asantos2000/TelosB/pictures/Screen Shot 2016-05-10 at 8.43.21 AM.png

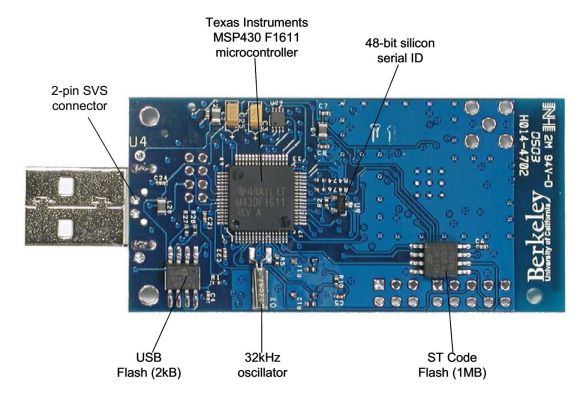
pictures/Screen Shot 2016-05-10 at 8.43.21 AM.png
