asantos2000/TelosB/pictures/Screen Shot 2016-05-10 at 8.43.06 AM.png

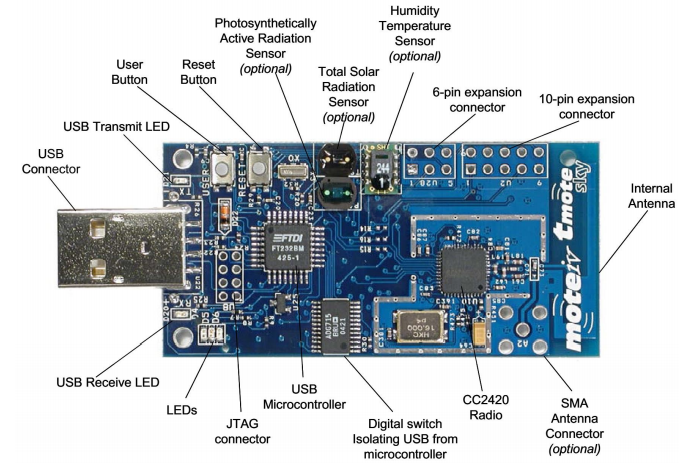
pictures/Screen Shot 2016-05-10 at 8.43.06 AM.png
