asantos2000/TelosB/UCB/README.txt

PCB DECRIPTION: 1.267 inches x 2.582 inches
                4 LAYER PCB 1.0 MM (0.040 inch) FR4
                LAYER SPACING:
                1-2 0.25 MM
                2-3 0.4 MM
                3-4 0.25 MM
                1 oz copper pour, solder plated finish
                DOUBLE SIDE SOLDER MASK,
                DOUBLE SIDE SILKSCREEN,
                8 MIL MIN TRACE WIDTH AND 8 MIL MIN ISOLATION BOT,IN1,GND
                6 MIL MIN TRACE WIDTH AND 6 MIL MIN ISOLATION TOP
                10 MIL MIN HOLE SIZE

Note: Please use green silk screen

The left side of the board has an inverted-F antenna with 
no surface mount pads. PLEASE DO NOT PUT ANY COPPER MARKINGS
IN THAT AREA.

Questions?
  Please contact Joe Polastre <polastre@cs.berkeley.edu>
  at 510.388.2112 with any problems or questions

TOP.GBX - Top Copper
GND.GBX - Inner Plane Negative Polarity
IN1.GBX - Inner Plane Positive Polarity
BOT.GBX - Bottom Copper

drill.nc - NC Drill File

SMT.GBX - Surface Mount Top
SMB.GBX - Surface Mount Bottom

SST.GBX - Silk Screen Top
SSB.GBX - Slik Screen Bottom

telos-ti-63fab.dxf - fabrication drawing

Note: TELOS-TI-63b.GTD is a GerbTool V10 file that contains the above layers
