asantos2000/TelosB/pictures/BOT.GBX.png

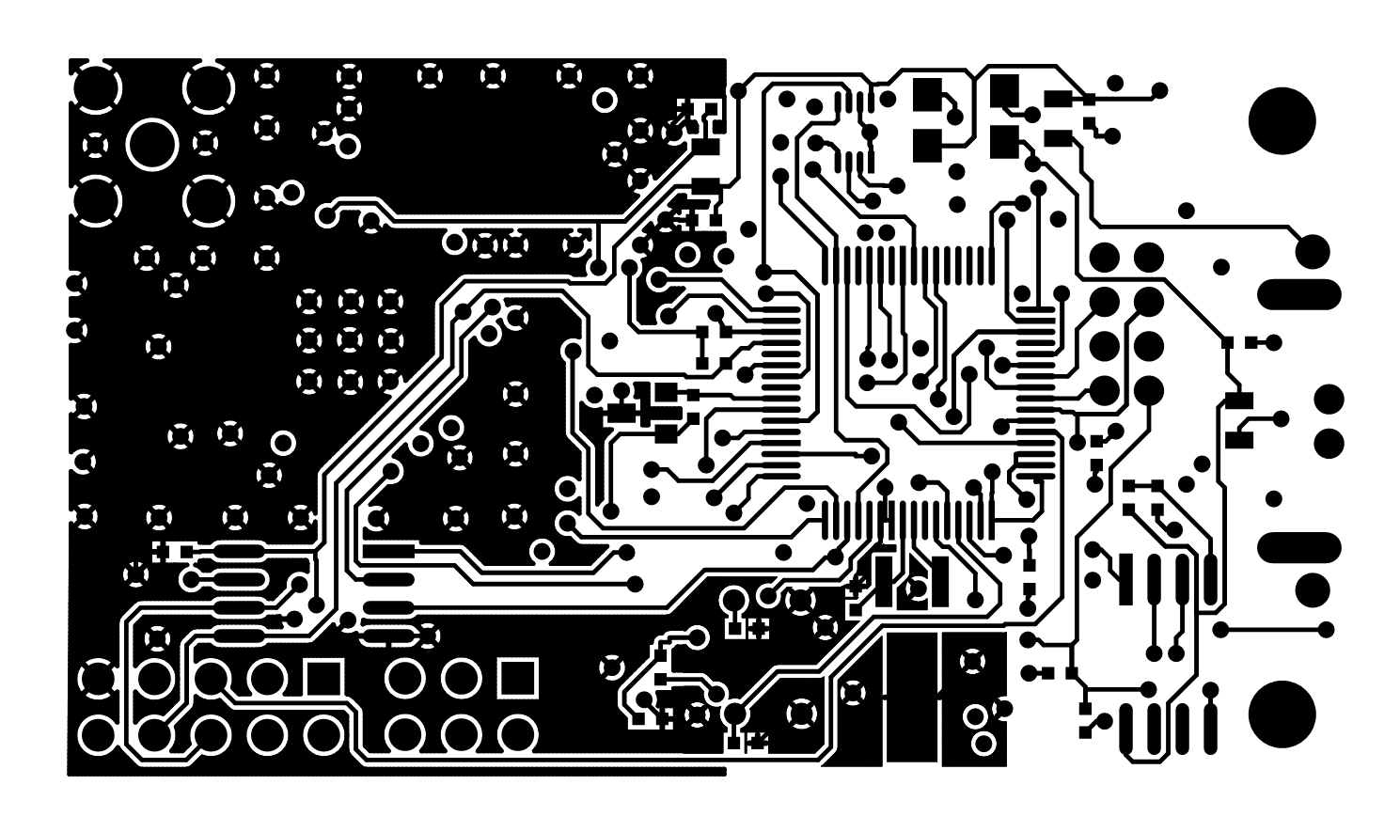
pictures/BOT.GBX.png
