asantos2000/TelosB/pictures/GND.GBX.png

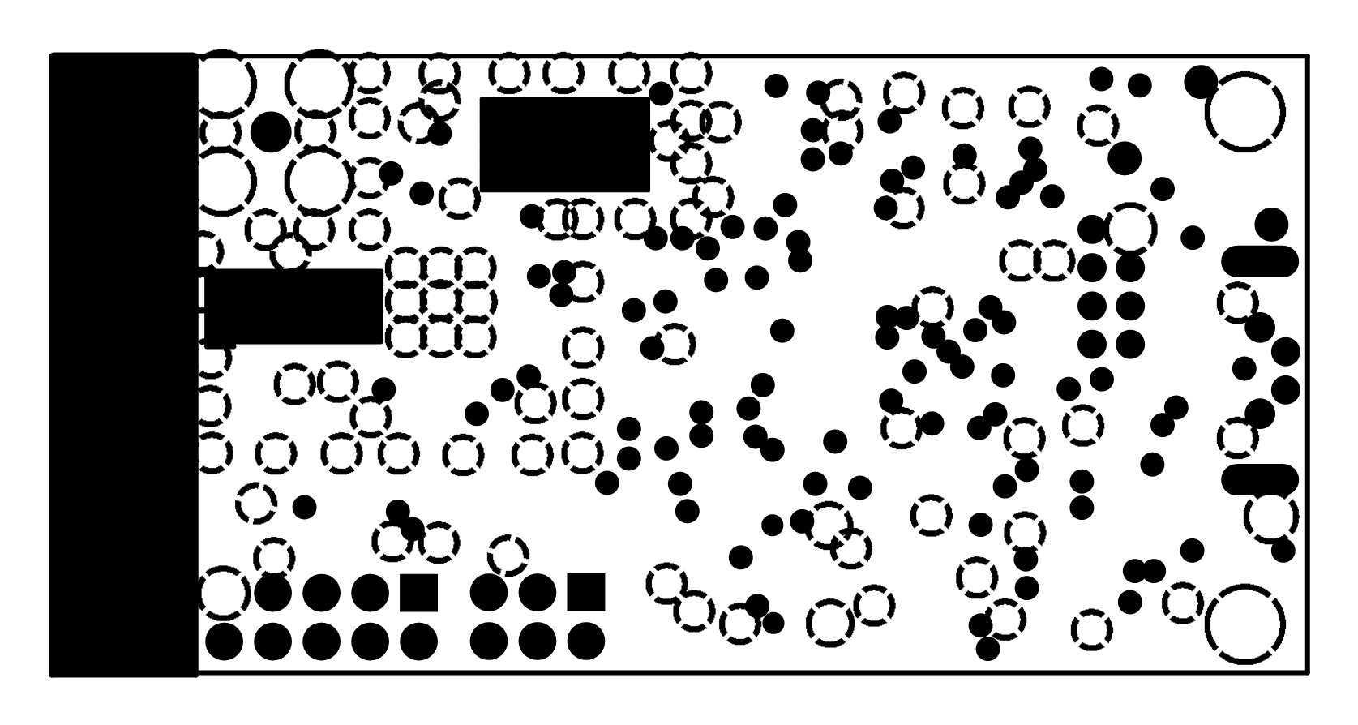
pictures/GND.GBX.png
