asantos2000/TelosB/pictures/IN1.GBX.png

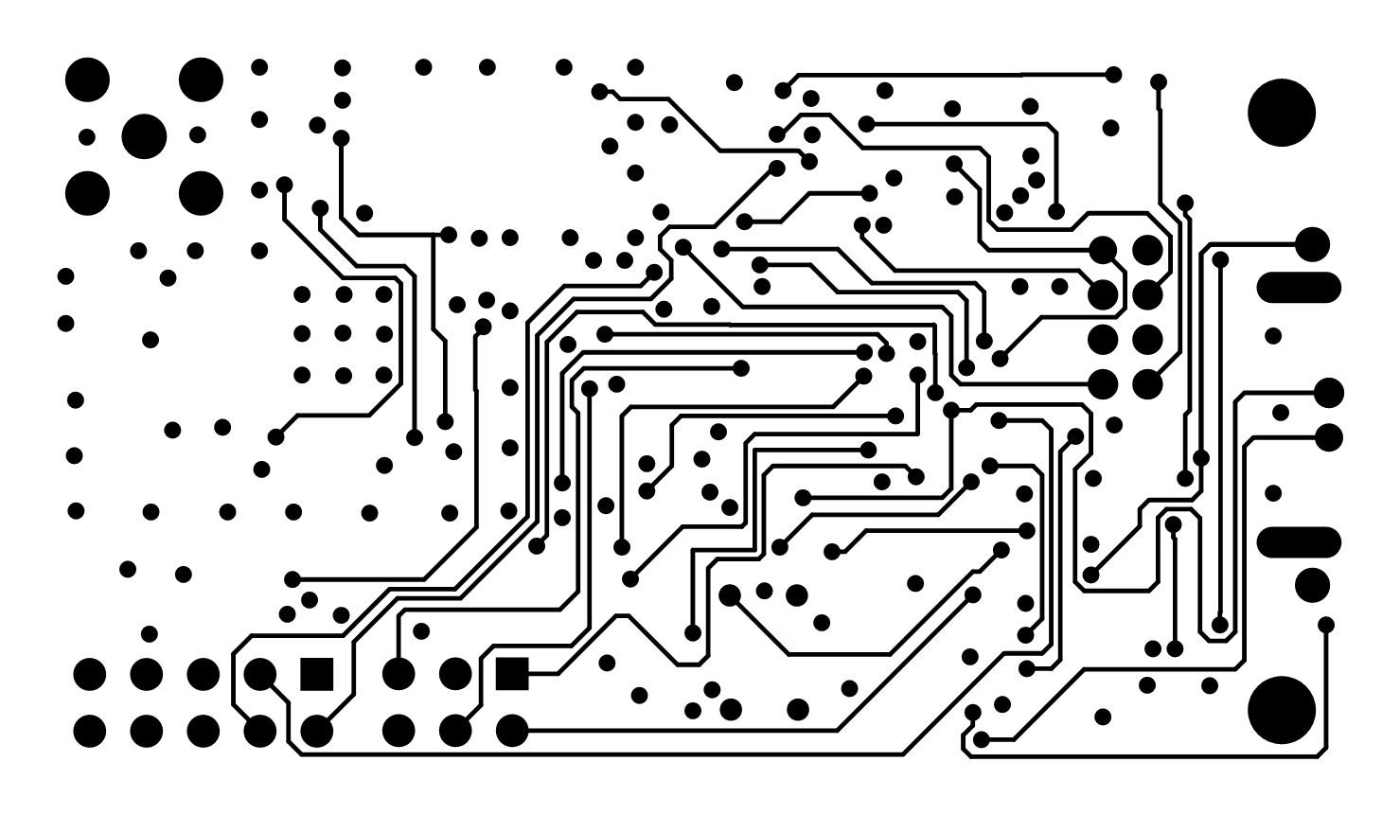
pictures/IN1.GBX.png
