asantos2000/TelosB/pictures/SMB.GBX.png

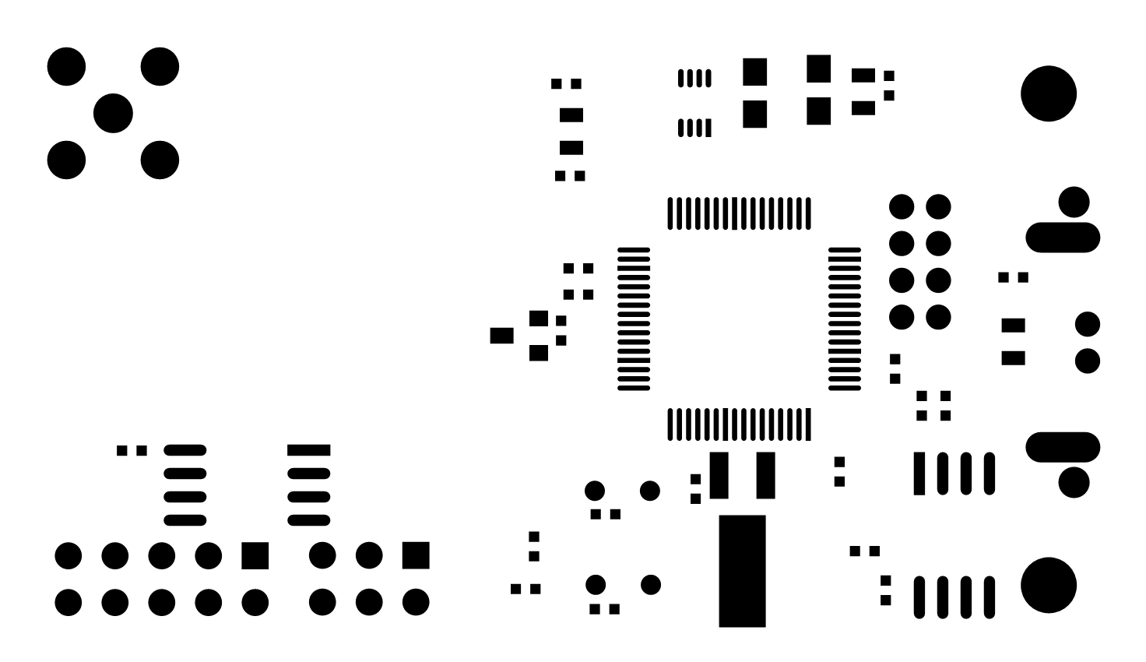
pictures/SMB.GBX.png
