asantos2000/TelosB/pictures/SSB.GBX.png

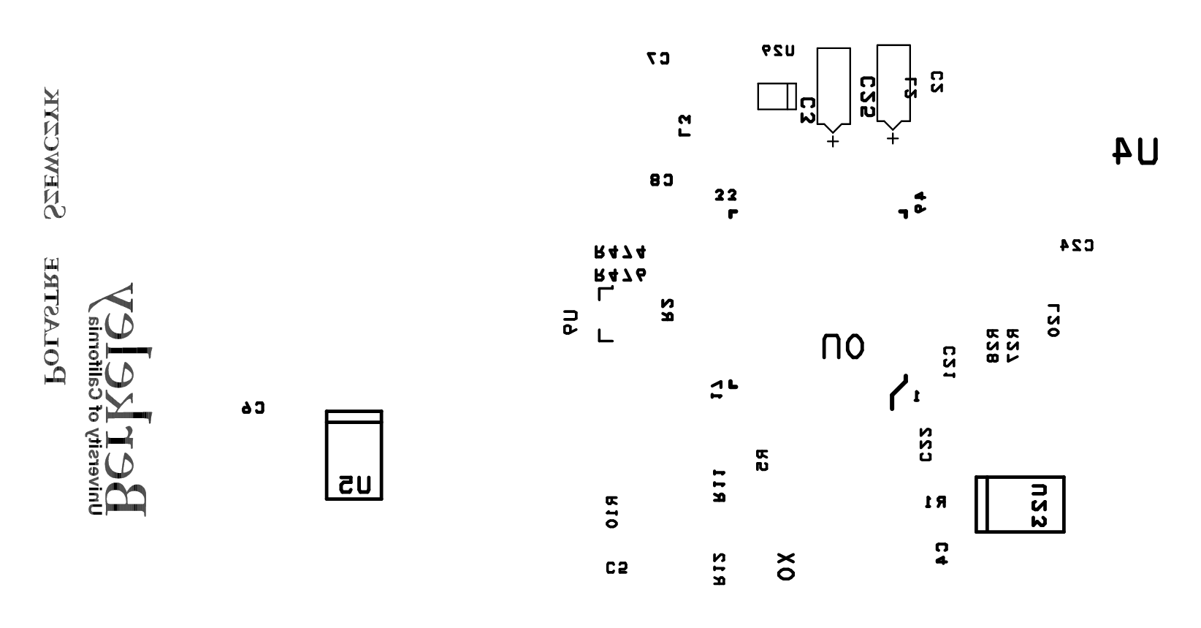
pictures/SSB.GBX.png
