asantos2000/TelosB/pictures/SST.GBX.png

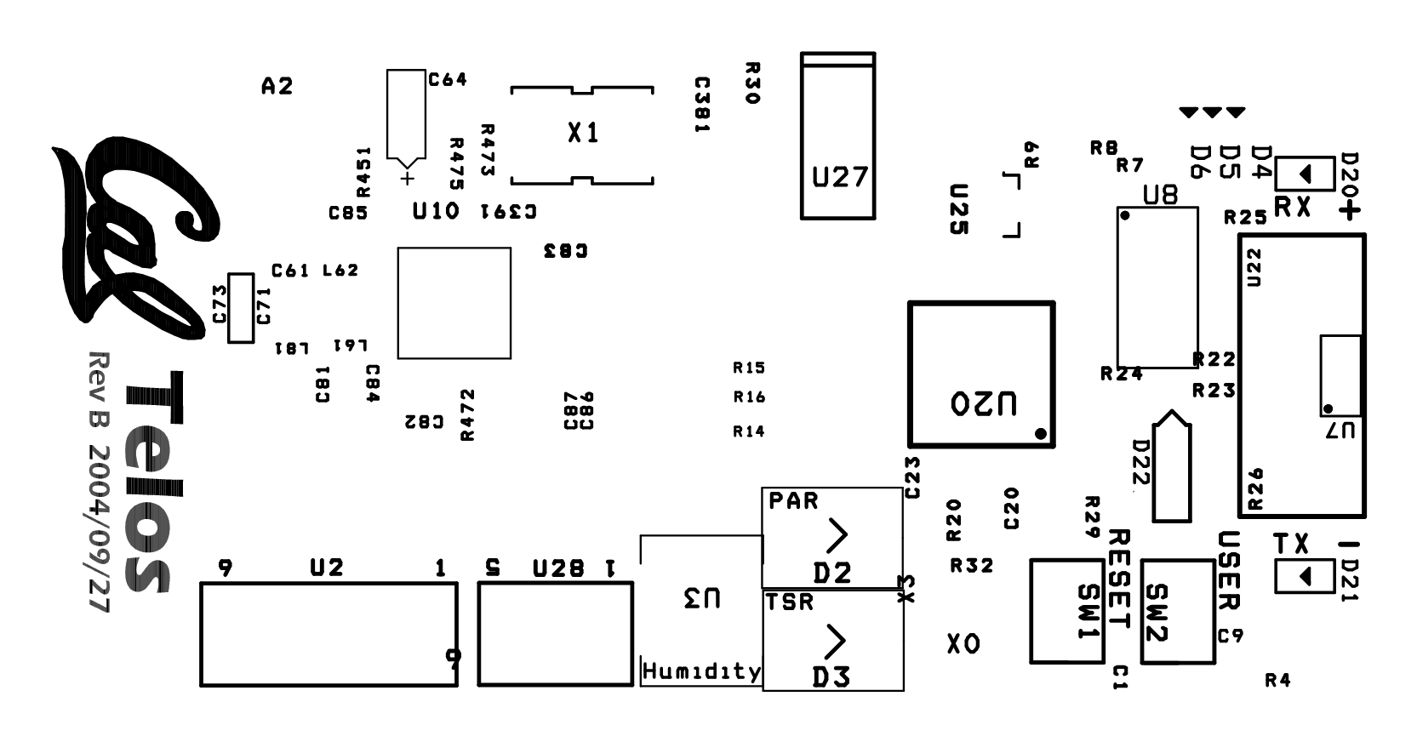
pictures/SST.GBX.png
