asantos2000/TelosB/pictures/telos-ti-63fab.png

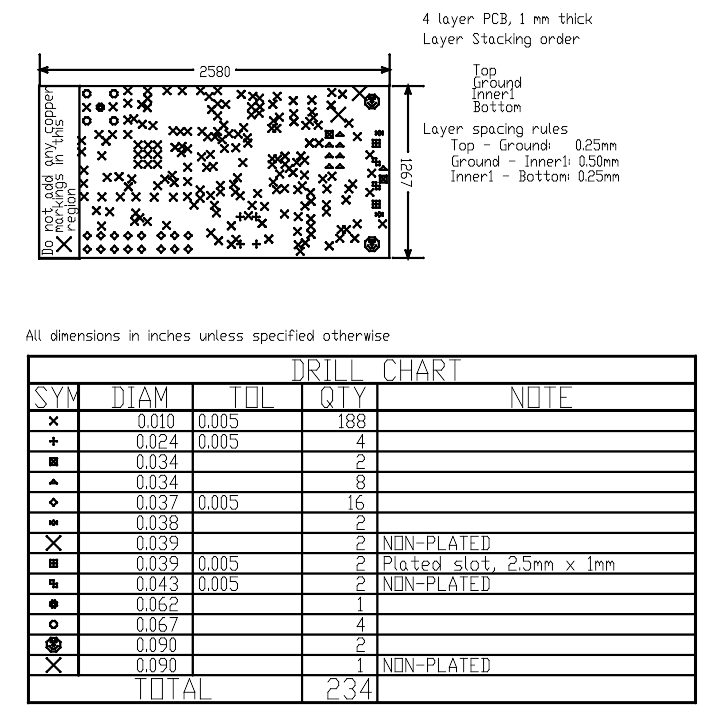
pictures/telos-ti-63fab.png
