asantos2000/TelosB/pictures/TOP.GBX.png

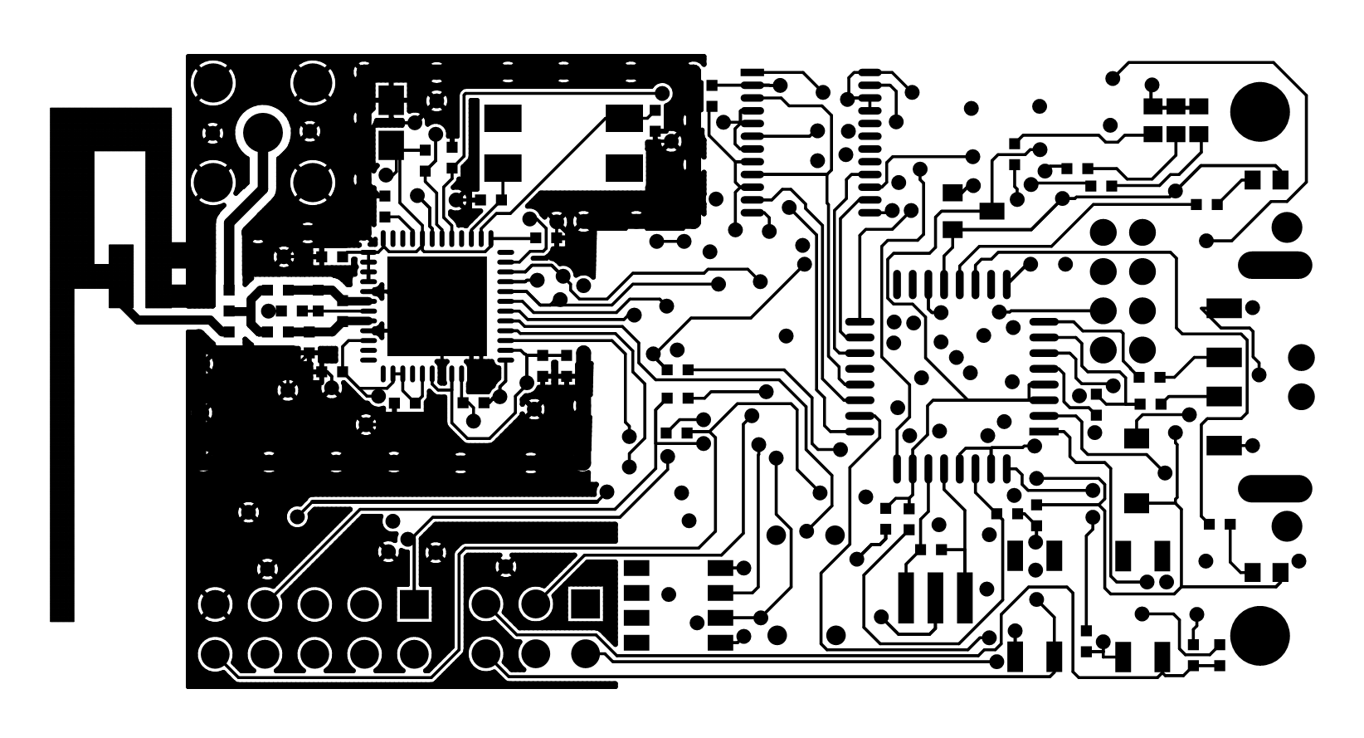
pictures/TOP.GBX.png
