asantos2000/TelosB/telos-revb-bom-2016-05-24.xlsx

Sheet: proposta
maggie@winwin-custom.com |  |  | angel@morepcb.com |  |  | sales@umebay.net
Qde | 10 | 50 | Qde | 10 | 50 | Qde | 10 | 50
MOQ (PCB) | 6.00 | 1.60 | MOQ (PCB) |  |  | MOQ (PCB) | 3.60 | 1.06
COMP (elect. parts) | 42.28 | 42.28 | COMP (elect. parts) |  |  | COMP (elect. parts) | 50.00 | 41.40
Assembly (SMT) | 14.40 | 8.00 | Assembly (SMT) |  |  | Assembly (SMT) | 10.00 | 3.00
Stencil | 30.00 | 30.00 | Stencil |  |  | Stencil
Total | 656.78 | 2623.90 | Total | 300.00 | 1250.00 | Total | 636.00 | 2273.00
Unit USD | 65.678 | 52.478 | Unit USD | 30 | 25 | Unit USD | 63.6 | 45.46

Sheet: UMEBAY
UMEBAY ELECTRONICS COMPANY LIMITED http://www.umebay.net
Shenzhen Add: B2303, 3 Lipu road Bantian , Longgang District, Shenzhen, P.R.C
Tel:0755-83209137 skype:xiangtao.ouyang
Email address: sales@umebay.net
Quotation sheet
In#NO.TR2016051101
Date 11.May.2016
FOR:Anderson (adsantos@gmail.com)
Project name | size | quantity | PCB fee | SMT fee | Cost of electronic part | other | total (USD)
telos-revb-r63 | 1.267*2.582 | 10pcs | $36.00 | $100.00 | $500.00 |  | $636.00
telos-revb-r63 | 1.267*2.582 | 50pcs | $53.00 | $150.00 | $2070.00 |  | $2273.00
not: Production time (7-15days) All parts are high quality.
Accept:PAYPAL ,Aliexpress ,T/T payment
Free shipping to your designated location
 |  |  |  |  |  | date: | 2016 May 11th

Sheet: winwin_telos-bom-2016-05-24
Telos (Rev B) Revised: Saturday, September 21, 2004
(c) Copyright 2004: UC Berkeley Revision: B
Bill Of Materials May 24,2016 10:00:00
Item | Quantity | Reference | Part | Footprint | price | total
______________________________________________
1 | 1 | A1 | CC2420_PCB_ANT | ANTENNA/CC2420
2 | 1 | C84 | 10n | SM/C_0402 | 0.007 | 0.007
3 | 1 | C21 | 33n | SM/C_0402 | 0.007 | 0.007
4 | 2 | C81,C61 | 0.5p +/-0.25p np0 | SM/C_0402 | 0.011 | 0.022
5 | 2 | C71,C73 | 5.6p +/-0.25p np0 | SM/C_0402/DUAL/INLINE | 0.011 | 0.022
6 | 2 | C381,C391 | 22p 5% np0 | SM/C_0402 | 0.007 | 0.014
7 | 3 | C82,C83,C86 | 68p | SM/C_0402 | 0.007 | 0.021
8 | 14 | C1,C2,C4,C5,C6,C7,C8,C9,C20,C22,C23,C24,C85,C87 | 0.1u | SM/C_0402 | 0.007 | 0.098
9 | 3 | C3,C25,C64 | 10uF LowESR < 5ohm | SM/TANT_A_NUM | 0.540 | 1.620 | TPSC106K025R0500
10 | 2 | D4,D21 | Red Clear - QTLP601C-7 | LED SMD 0603 NUM | 0.017 | 0.034
11 | 2 | D5,D20 | Green Clear - QTLP601C-4 | LED SMD 0603 NUM | 0.017 | 0.034
12 | 1 | D6 | Blue Clear - QTLP601C-EB | LED SMD 0603 NUM | 0.022 | 0.022
13 | 1 | D22 | 1N5817 | SSS Mini 2P | 0.065 | 0.065
14 | 3 | J10,J11,J12 | HOLE | 90_mil_hole | 0.420 | 1.260
15 | 3 | L2,L3,L20 | F Bead 240-1035-1 | SM/C_0805 | 0.022 | 0.066
16 | 1 | L62 | 5.6n 5% | SM/C_0402 | 0.017 | 0.017
17 | 2 | L81,L61 | 7.5n 5% | SM/C_0402 | 0.017 | 0.034
18 | 1 | R475 | 0 | SM/C_0402 | 0.004 | 0.004
19 | 2 | R22,R23 | 27 | SM/C_0402 | 0.004 | 0.008
20 | 3 | R9,R25,R26 | 100 | SM/C_0402 | 0.004 | 0.012
21 | 1 | R8 | 220 | SM/C_0402 | 0.004 | 0.004
22 | 2 | R7,R20 | 470 | SM/C_0402 | 0.004 | 0.008
23 | 1 | R24 | 1.5k | SM/C_0402 | 0.004 | 0.004
24 | 2 | R2,R27 | 2.2k | SM/C_0402 | 0.004 | 0.008
25 | 6 | R10,R28,R29,R30,R474,R476 | 10k | SM/C_0402 | 0.004 | 0.024
26 | 1 | R451 | 43k 1% | SM/C_0402 | 0.004 | 0.004
27 | 3 | R1,R11,R12 | 100k 1% | SM/C_0402 | 0.004 | 0.012
28 | 1 | R4 | 470k | SM/C_0402 | 0.004 | 0.004
29 | 3 | R32,R472,R473 | 1m | SM/C_0402 | 0.004 | 0.012
30 | 1 | R5 | 5.1m | SM/C_0402 | 0.004 | 0.004
31 | 2 | SW2,SW1 | EVQ-P2K02Q | SW/EVQP2 | 0.542 | 1.084
32 | 1 | U0 | TI_MSP430_F1611 | QUAD.50M/64/WG12.00 | 5.940 | 5.940 | MSP430F1611IPM
33 | 1 | U4 | PWR_CONN | AA AA Battery Storage Case Plastic Box Holder with 6'' Cable Lead for 2 x AA 1.5V | 0.300 | 0.300
34 | 1 | U5 | M25P80 | SOIC 8PIN 150MIL | 0.433 | 0.433 | M25P80-VMW6TG
35 | 1 | U9 | DS2411 | SOT321 | 0.368 | 0.368
36 | 1 | U10 | CC2420 | QLP/48 | 3.510 | 3.510 | CC2420RGZR
37 | 1 | U20 | FT232BM | LQFP/32-LD | 3.420 | 3.420 | FT232BL (new)
38 | 1 | U22 | USB A | USB-A-SPM-K-O-L | 0.065 | 0.065
39 | 1 | U23 | M93C56-WMN6P | SOIC 8PIN 150MIL | 0.400 | 0.400
40 | 1 | U25 | MCP1700T-3302TT | SOT231 | 0.433 | 0.433
41 | 1 | U27 | ADG715BRU | TSSOP/24 | 4.225 | 4.225
42 | 1 | U29 | NC7WZ126 | US/8 | 0.184 | 0.184 | NC7WZ126K8X
43 | 1 | X0 | 32kHz | CMR200TB | 0.130 | 0.130
44 | 1 | X1 | 16MHZ - 16pf | HK-XTAL-7X5 | 0.238 | 0.238
45 | 1 | X3 | 6M resonator | MURATA_CSTCR CSTCR6M00G53-RO CSTCR 6 MHZ | 0.198 | 0.198
SENSORS
46 | 1 | D2 | S1087 Photodiode | HAM S1087 | 6.000 | 6.000
47 | 1 | D3 | S1087-01 Photodiode | HAM S1087 | 5.660 | 5.660
48 | 1 | U3 | SHT11 | SHT11_SMALL | 6.140 | 6.140 | IC
 |  |  |  |  |  | 0.000
DO NOT POPULATE |  |  |  |  |  | 0.000
49 | 1 | A2 | SMA | SMA_PCB |  | 0.000
50 | 3 | R14,R15,R16 | 0 open | SM/C_0402
51 | 1 | U2 | 10pin Header - 0.1" | BLKCON.100/VH/TM2OE/W.200/10 | 0.033 | 0.033
52 | 1 | U7 | 2pin Header - 2mm | BLKCON2MM/2/2 | 0.022 | 0.022
53 | 1 | U8 | 8pin Header - 2mm | BLKCON2MM/2/8 | 0.022 | 0.022
54 | 1 | U28 | 6pin Header - 0.1" | BLKCON.100/VH/TM2OE/W.200/6 | 0.022 | 0.022
 |  |  |  |  |  | 42.278
