asantos2000/TelosB/telos-revb-bom-2004-09-21.xls

Telos (Rev B) Revised: Saturday, September 21, 2004
(c) Copyright 2004: UC Berkeley Revision: B
Bill Of Materials September 21,2004 19:25:18
Item | Quantity | Reference | Part | Footprint
______________________________________________
1 | 1 | A1 | CC2420_PCB_ANT | ANTENNA/CC2420
2 | 1 | C84 | 10n | SM/C_0402
3 | 1 | C21 | 33n | SM/C_0402
4 | 2 | C81,C61 | 0.5p +/-0.25p np0 | SM/C_0402
5 | 2 | C71,C73 | 5.6p +/-0.25p np0 | SM/C_0402/DUAL/INLINE
6 | 2 | C381,C391 | 22p 5% np0 | SM/C_0402
7 | 3 | C82,C83,C86 | 68p | SM/C_0402
8 | 14 | C1,C2,C4,C5,C6,C7,C8,C9,C20,C22,C23,C24,C85,C87 | 0.1u | SM/C_0402
9 | 3 | C3,C25,C64 | 10uF LowESR < 5ohm | SM/TANT_A_NUM
10 | 2 | D4,D21 | Red Clear - QTLP601C-7 | LED SMD 0603 NUM
11 | 2 | D5,D20 | Green Clear - QTLP601C-4 | LED SMD 0603 NUM
12 | 1 | D6 | Blue Clear - QTLP601C-EB | LED SMD 0603 NUM
13 | 1 | D22 | 1N5817 | SSS Mini 2P
14 | 3 | J10,J11,J12 | HOLE | 90_mil_hole
15 | 3 | L2,L3,L20 | F Bead 240-1035-1 | SM/C_0805
16 | 1 | L62 | 5.6n 5% | SM/C_0402
17 | 2 | L81,L61 | 7.5n 5% | SM/C_0402
18 | 1 | R475 | 0 | SM/C_0402
19 | 2 | R22,R23 | 27 | SM/C_0402
20 | 3 | R9,R25,R26 | 100 | SM/C_0402
21 | 1 | R8 | 220 | SM/C_0402
22 | 2 | R7,R20 | 470 | SM/C_0402
23 | 1 | R24 | 1.5k | SM/C_0402
24 | 2 | R2,R27 | 2.2k | SM/C_0402
25 | 6 | R10,R28,R29,R30,R474,R476 | 10k | SM/C_0402
26 | 1 | R451 | 43k 1% | SM/C_0402
27 | 3 | R1,R11,R12 | 100k 1% | SM/C_0402
28 | 1 | R4 | 470k | SM/C_0402
29 | 3 | R32,R472,R473 | 1m | SM/C_0402
30 | 1 | R5 | 5.1m | SM/C_0402
31 | 2 | SW2,SW1 | EVQ-P2K02Q | SW/EVQP2
32 | 1 | U0 | TI_MSP430_F1611 | QUAD.50M/64/WG12.00
33 | 1 | U4 | PWR_CONN | AA
34 | 1 | U5 | M25P80 | SOIC 8PIN 150MIL
35 | 1 | U9 | DS2411 | SOT321
36 | 1 | U10 | CC2420 | QLP/48
37 | 1 | U20 | FT232BM | LQFP/32-LD
38 | 1 | U22 | USB A | USB-A-SPM-K-O-L
39 | 1 | U23 | 93C46 | SOIC 8PIN 150MIL
40 | 1 | U25 | MCP1700T-3302TT | SOT231
41 | 1 | U27 | ADG715BRU | TSSOP/24
42 | 1 | U29 | NC7WZ126 | US/8
43 | 1 | X0 | 32kHz | CMR200TB
44 | 1 | X1 | 16MHZ - 16pf | HK-XTAL-7X5
45 | 1 | X3 | 6M resonator | MURATA_CSTCR
SENSORS
46 | 1 | D2 | S1087 Photodiode | HAM S1087
47 | 1 | D3 | S1087-01 Photodiode | HAM S1087
48 | 1 | U3 | SHT11 | SHT11_SMALL
DO NOT POPULATE
49 | 1 | A2 | SMA | SMA_PCB
50 | 3 | R14,R15,R16 | 0 open | SM/C_0402
51 | 1 | U2 | 10pin Header - 0.1" | BLKCON.100/VH/TM2OE/W.200/10
52 | 1 | U7 | 2pin Header - 2mm | BLKCON2MM/2/2
53 | 1 | U8 | 8pin Header - 2mm | BLKCON2MM/2/8
54 | 1 | U28 | 6pin Header - 0.1" | BLKCON.100/VH/TM2OE/W.200/6
