asantos2000/TelosB/UCB/telos-ti-63fab.dxf

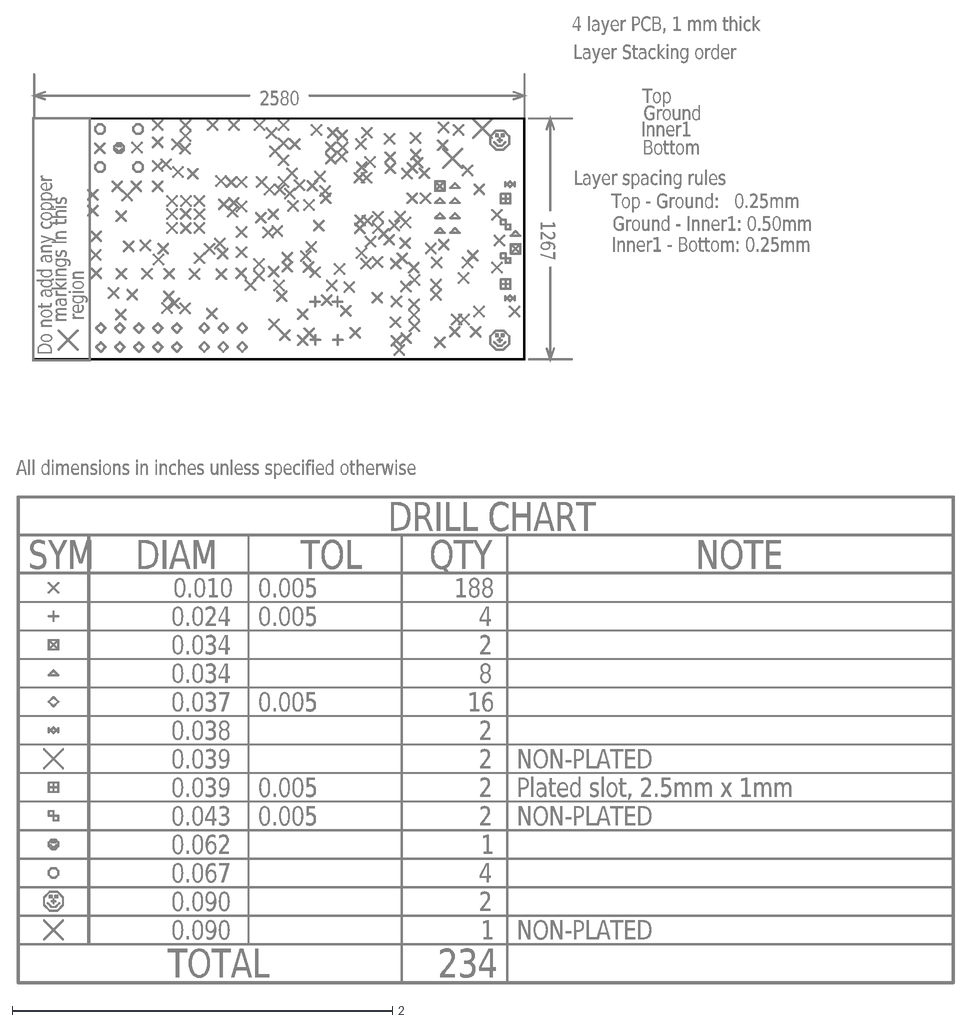
[picture p12: CAD file, 2016-05-24]
UCB/telos-ti-63fab.dxf
2580
1267
Layer Stacking order
Top
Ground
Inner1
Bottom
All dimensions in inches unless specified otherwise
Do not add any copper
markings in this
region
4 layer PCB, 1 mm thick
Layer spacing rules
Top - Ground: 0.25mm
Ground - Inner1: 0.50mm
Inner1 - Bottom: 0.25mm
DRILL CHART
SYM
DIAM
TOL
QTY
NOTE
0.010
0.005
188
0.024
4
0.034
2
8
0.037
16
0.038
0.039
NON-PLATED
Plated slot, 2.5mm x 1mm
0.043
0.062
1
0.067
0.090
TOTAL
234
