asantos2000/TelosB/pictures/telos-revb-2004-09-27_schematic.pdf

SENSORS | POWER

# RESET SWITCH

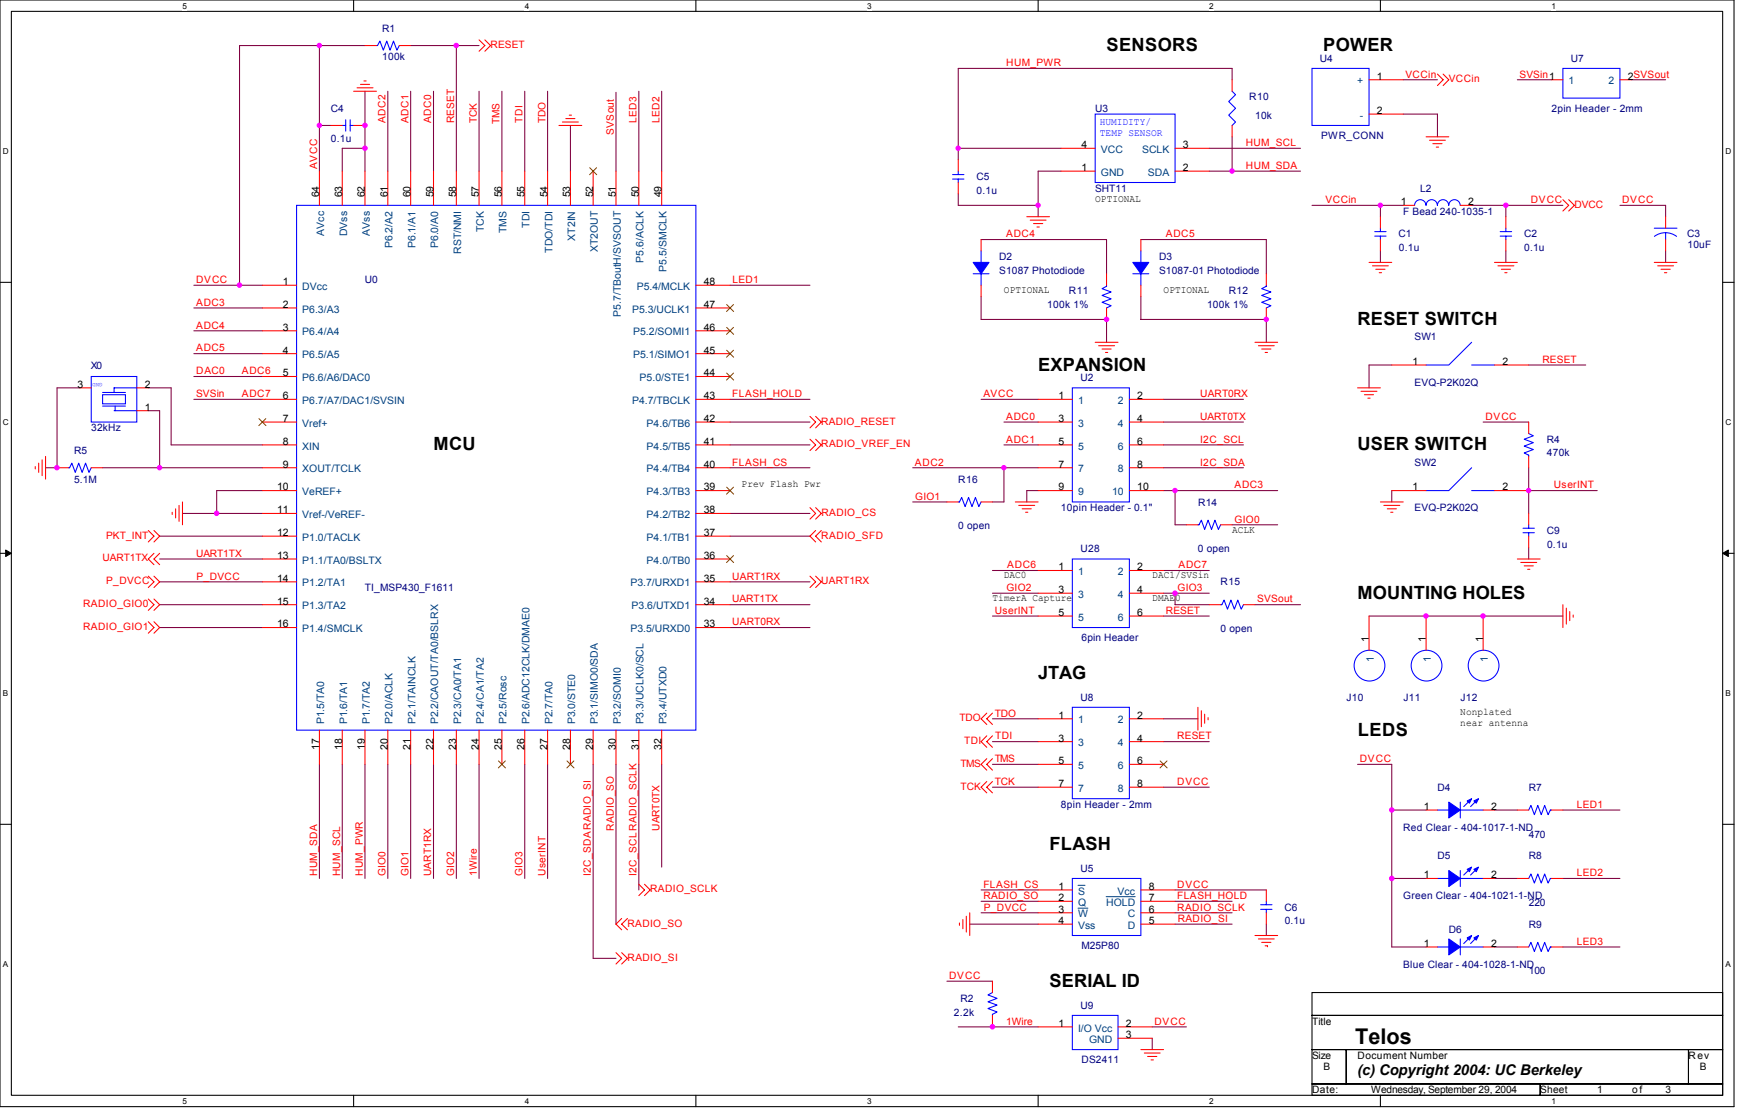
[picture p13: page 1]

Size B | Document Number (c) Copyright 2004: UC Berkeley | R ev B

Date: Wednesday, September 29, 2004 | Sheet 1 of 3

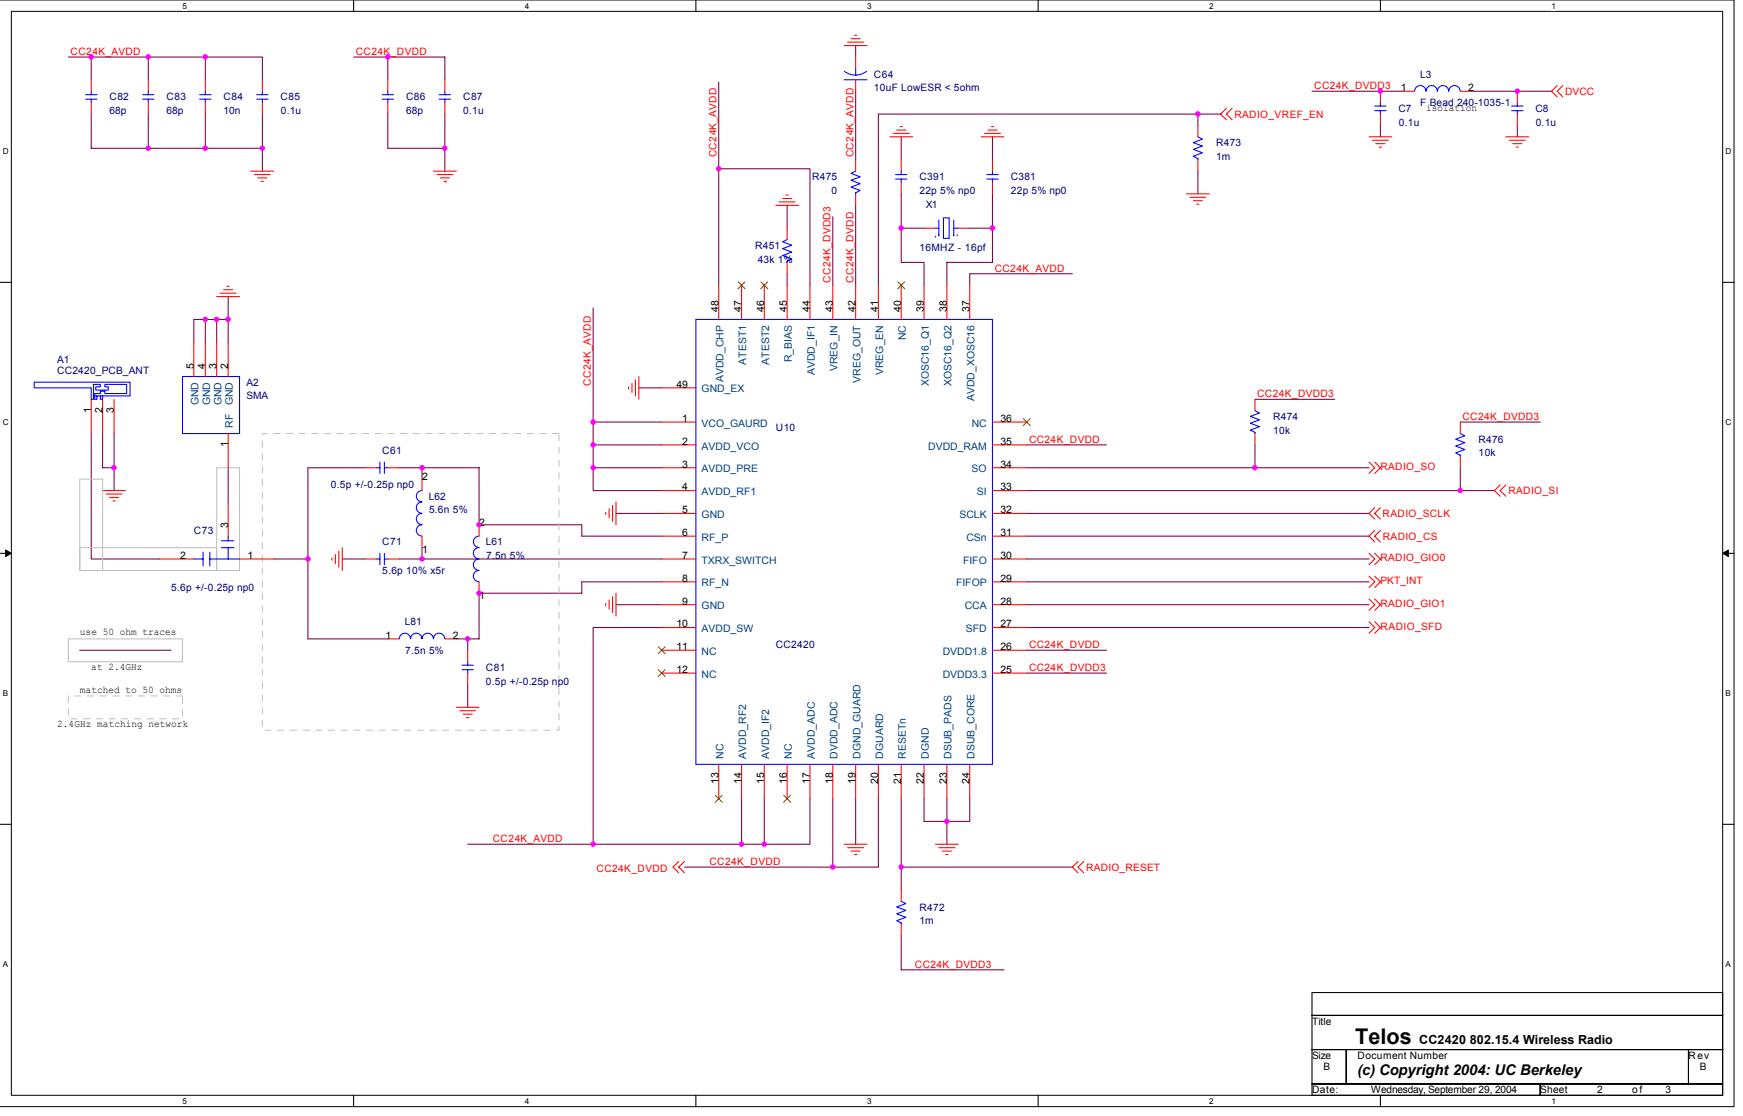
[picture p14: page 2]

Size B | Document Number (c) Copyright 2004: UC Berkeley | R ev B

Date: Wednesday, September 29, 2004 | Sheet 2 of 3

## Used for Reading Serial / Programming Connects and Powered via USB

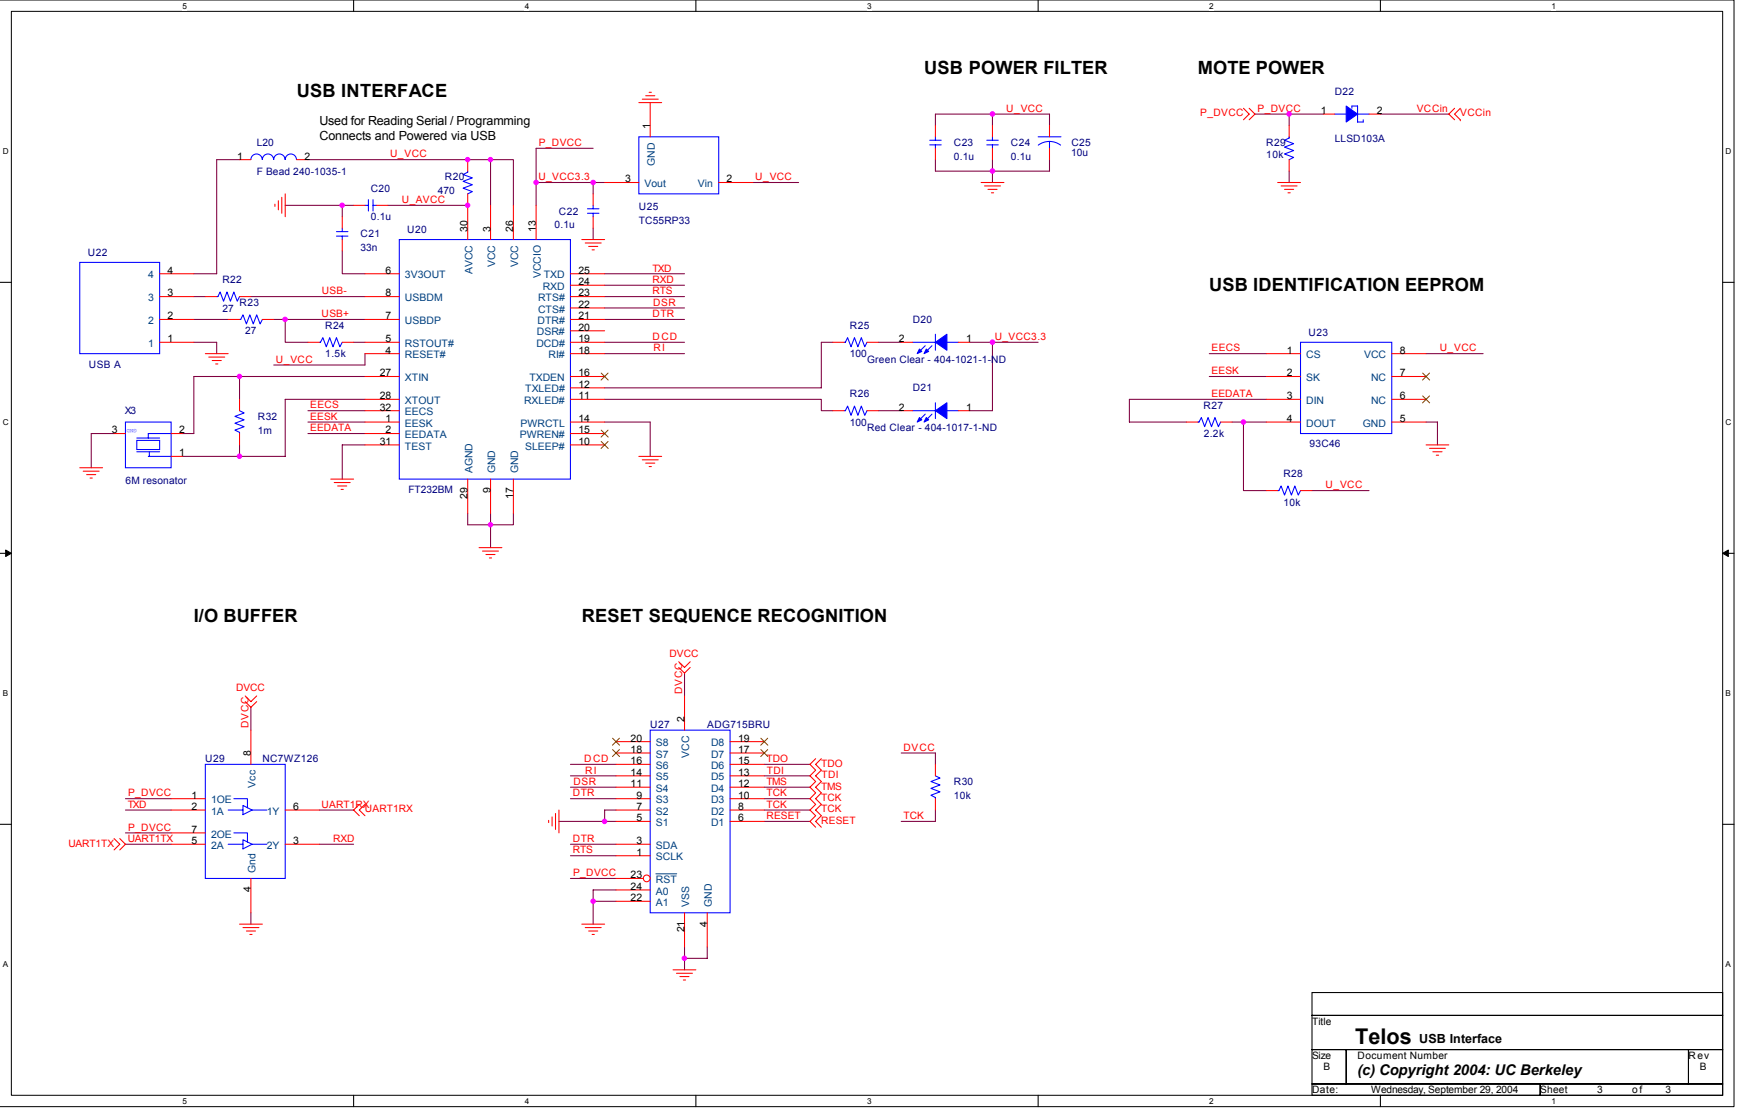
[picture p15: page 3]

RI# 18 DCD# 19 DSR# 20 DTR# 21 CTS# 22 RTS# 23 RXD 24 TXD 25 VCCIO ¹³

Size B | Document Number (c) Copyright 2004: UC Berkeley | R ev B

Date: Wednesday, September 29, 2004 | Sheet 3 of 3
