asantos2000/TelosB/(commit log)

2016-05-24 Initial
    Initial version
    [telos-revb-bom-2004-09-21.xls, telos-ti-63fab.dxf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]
2016-05-24 Quote
    BOM list revised by supplier.
    [telos-revb-bom-2016-05-24.xlsx]
